LEDs-by-glowingkitty/GlowCore/README.md

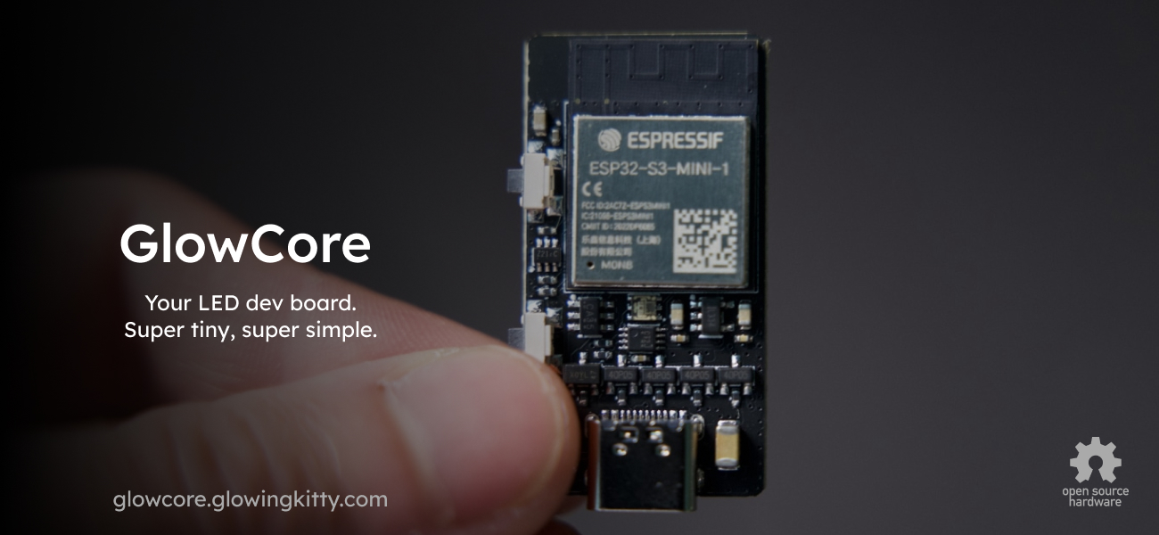
[picture p1: glowcore.jpg]
GlowCore


## What is this project?

A beautiful looking LED lamp for lighting up your home and setting the mood.

## Links

- [Shop](https://shop.glowingkitty.com/products/glowcore)
<!-- - [More details](https://glowingkitty.com/glowcore)
- [Tech specs](https://glowingkitty.com/glowcore/specs)
- [FAQ](https://glowingkitty.com/glowcore/faq)
- [Documents](https://glowingkitty.com/glowcore/docs)
- [3D files](https://glowingkitty.com/glowcore/3d)
- [PCB files](https://glowingkitty.com/glowcore/pcb) -->
