LEDs-by-glowingkitty/GlowCore/images/glowcore_backside.jpg

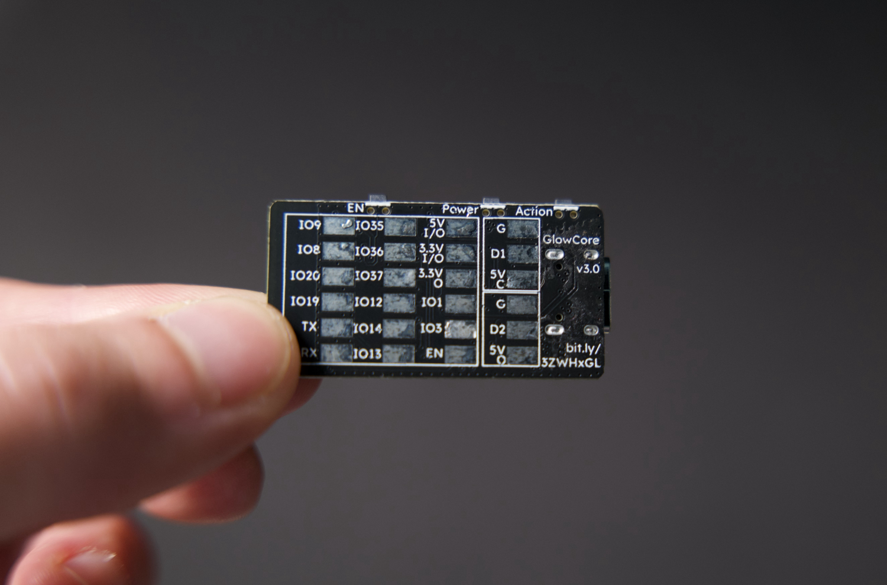
images/glowcore_backside.jpg
