LEDs-by-glowingkitty/GlowCore/images/glowcore_mainpicture.jpg

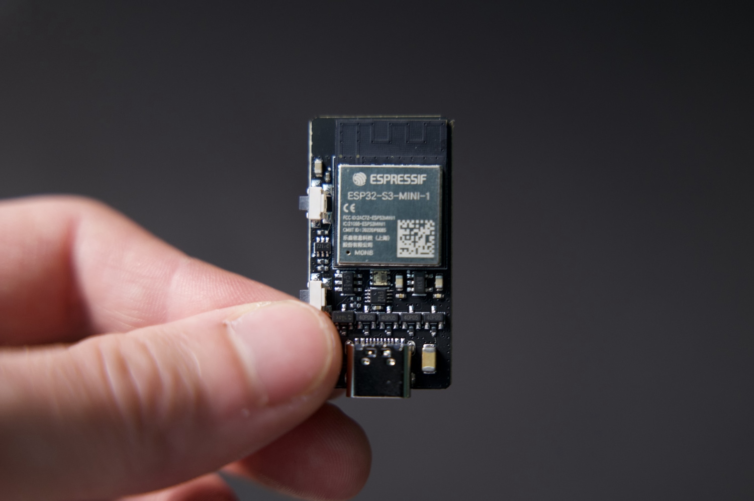
images/glowcore_mainpicture.jpg
