LEDs-by-glowingkitty/GlowCore/images/glowcore_packaging_back.jpg

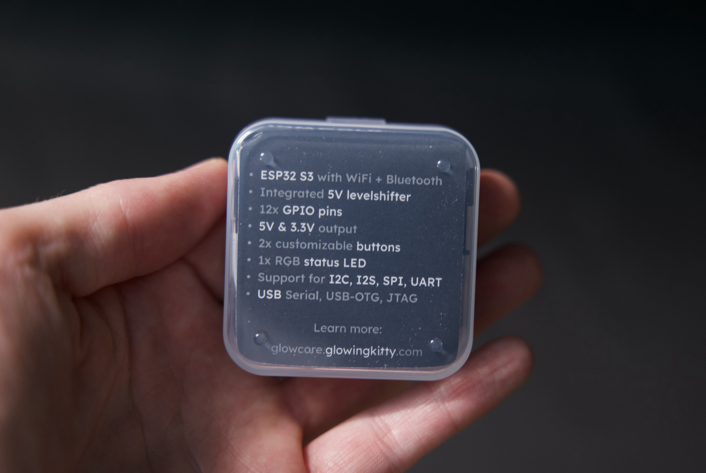
images/glowcore_packaging_back.jpg
