LEDs-by-glowingkitty/GlowCore/images/glowcore_packaging_front.jpg

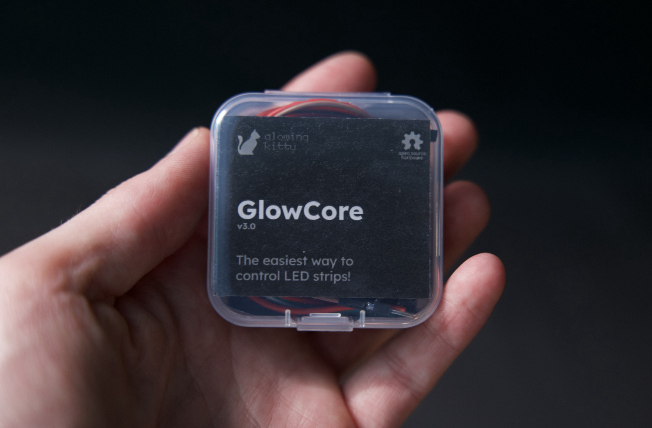
images/glowcore_packaging_front.jpg
