LEDs-by-glowingkitty/GlowCore/documents/GlowCore v3.0 pinout.pdf

# glowingkitty

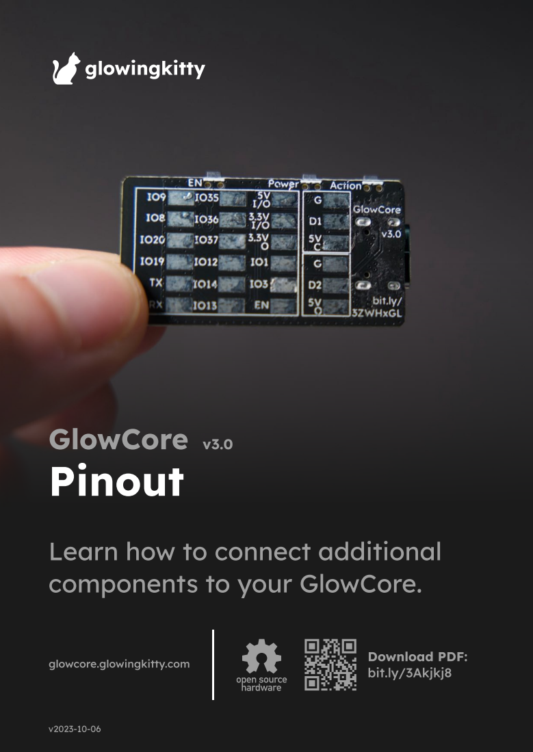
[picture p17: page 1]
GlowCore v3.0 Pinout; glowcore.glowingkitty.com; Download PDF:; bit.ly/3Akjkj8

Learn how to connect additional
components to your GlowCore.

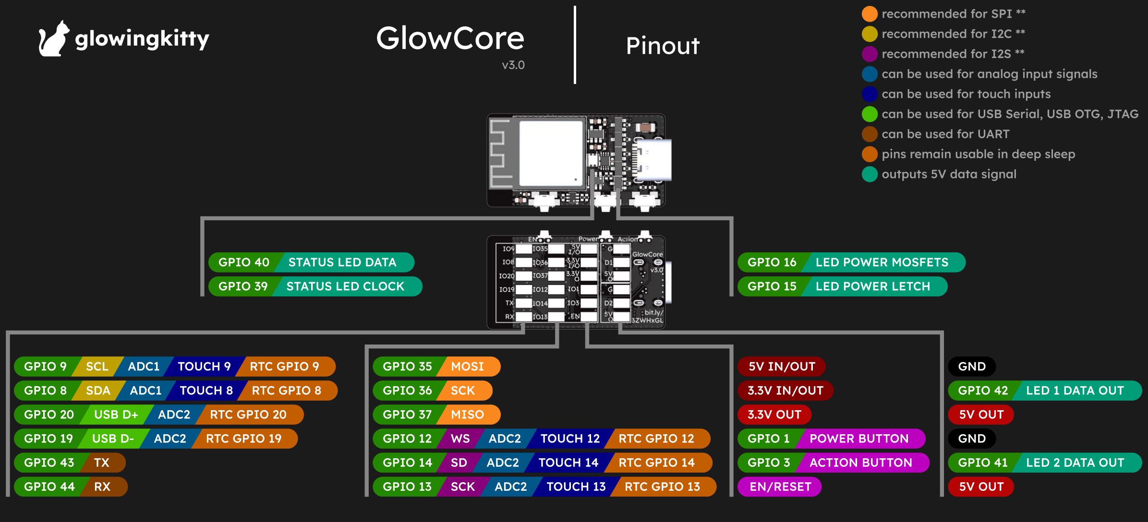
[picture p18: figure]
GlowCore; Pinout; recommended for SPI **; recommended for I2C **; recommended for I2S **; can be used for analog input signals; can be used for touch inputs; can be used for UART; pins remain usable in deep sleep; outputs 5V data signal; GND; GPIO 42; LED 1 DATA OUT; 5V OUT; GPIO 41; LED 2 DATA OUT; 5V IN/OUT; 3.3V IN/OUT; 3.3V OUT; GPIO 1; POWER BUTTON; GPIO 3; ACTION BUTTON; EN/RESET; GPIO 35; MOSI; GPIO 36; SCK; GPIO 37; MISO; GPIO 12; ADC2; TOUCH 12; RTC GPIO 12; GPIO 14; TOUCH 14; RTC GPIO 14; GPIO 13; TOUCH 13; RTC GPIO 13; GPIO 9; SCL; ADC1; TOUCH 9; RTC GPIO 9; GPIO 8; SDA; TOUCH 8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

can be used for USB Serial, USB OTG, JTAG

GPIO 3 | ACTION BUTTON
S | Next LED presec
S | Change brightness
| While holding the button, the brightness first
| decreases and once the minimum is reached, it
| increases again.
Press | Hold

Press

GPIO 1 | POWER BUTTON
S | Standby Mode
S | Turn off/on WiFi

Press

Press | Press
To turn on again, press the | once.

Every GPIO pin can be used for: I2C, SPI, I2S
Pull to GND, to trigger button (For your code, keep in mind: LOW signal will

be inverted to HIGH on GlowCore)

Button presets require GlowOS 0.15 or newer installed on GlowCore.

*

POWER BUTTON

**

***

*** | ***
glowcore.glowingkitty.com | Download PDF:

## bit.ly/3Akjkj8

v2023-10 06
