LEDs-by-glowingkitty/GlowCore/documents/GlowCore v3.0 schematic.pdf

# glowingkitty

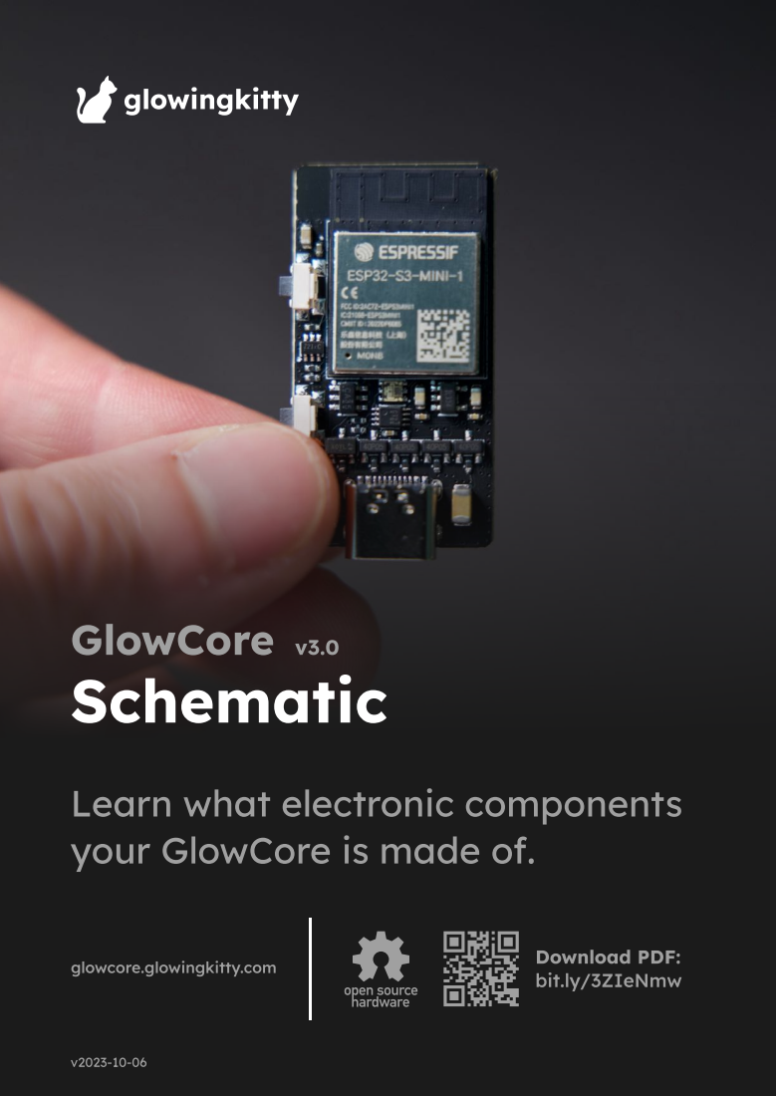
[picture p19: page 1]
GlowCore v3.0 Schematic; glowcore.glowingkitty.com; Download PDF:; bit.ly/3ZIeNmw

Learn what electronic components
your GlowCore is made of.

# GlowCore

# Schematic

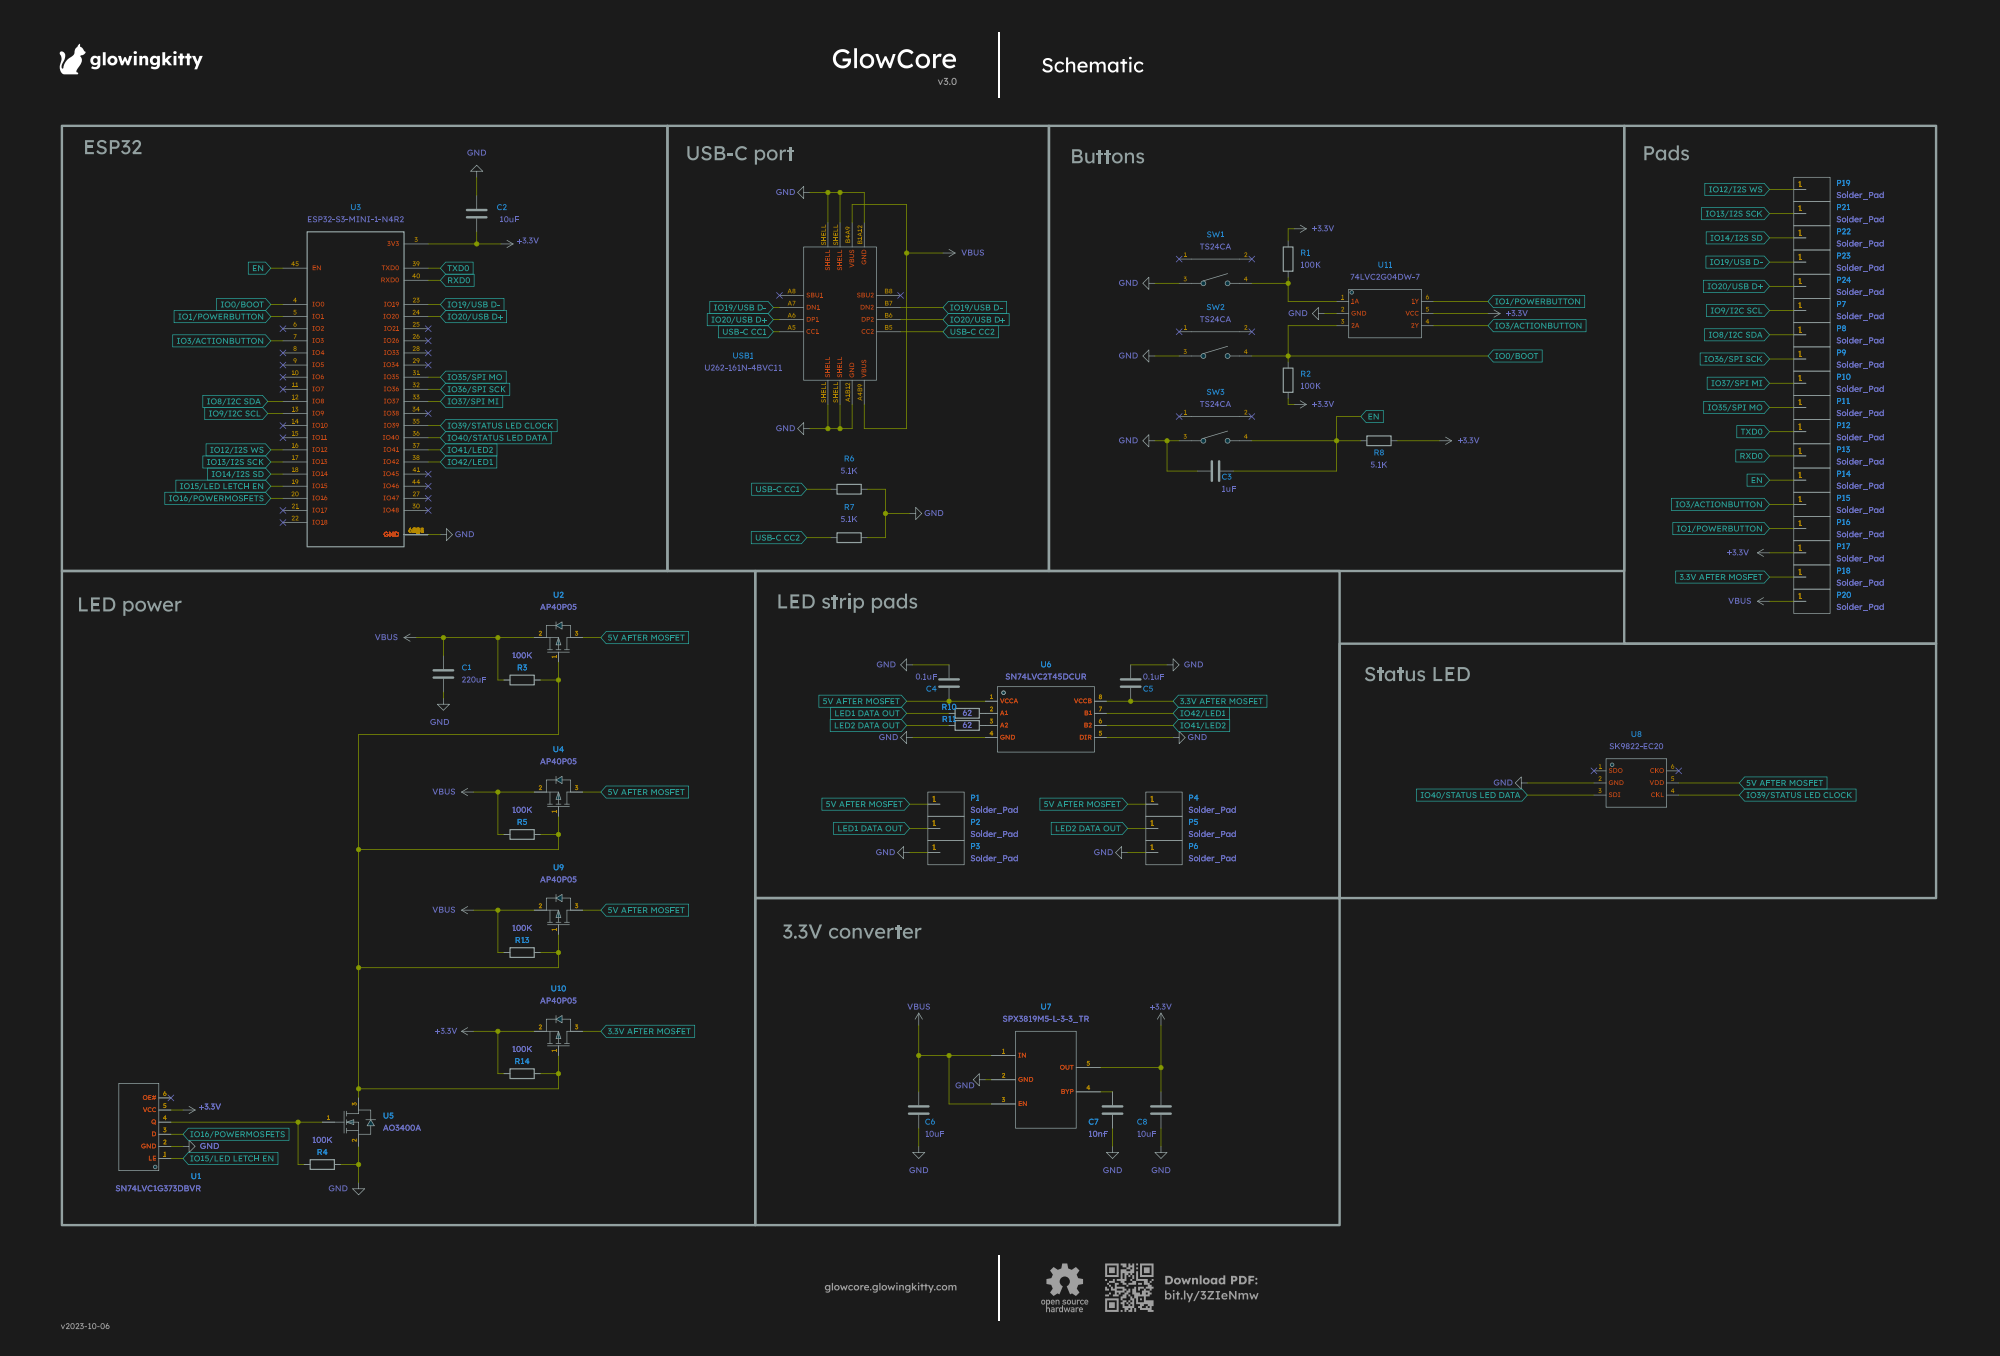
[picture p20: page 2]
glowcore.glowingkitty.com; Download PDF:; bit.ly/3ZIeNmw; glowingkitty
