LEDs-by-glowingkitty/GlowCore/elec/src/parts/buttons/TS_1185EC_C_D_B.pdf

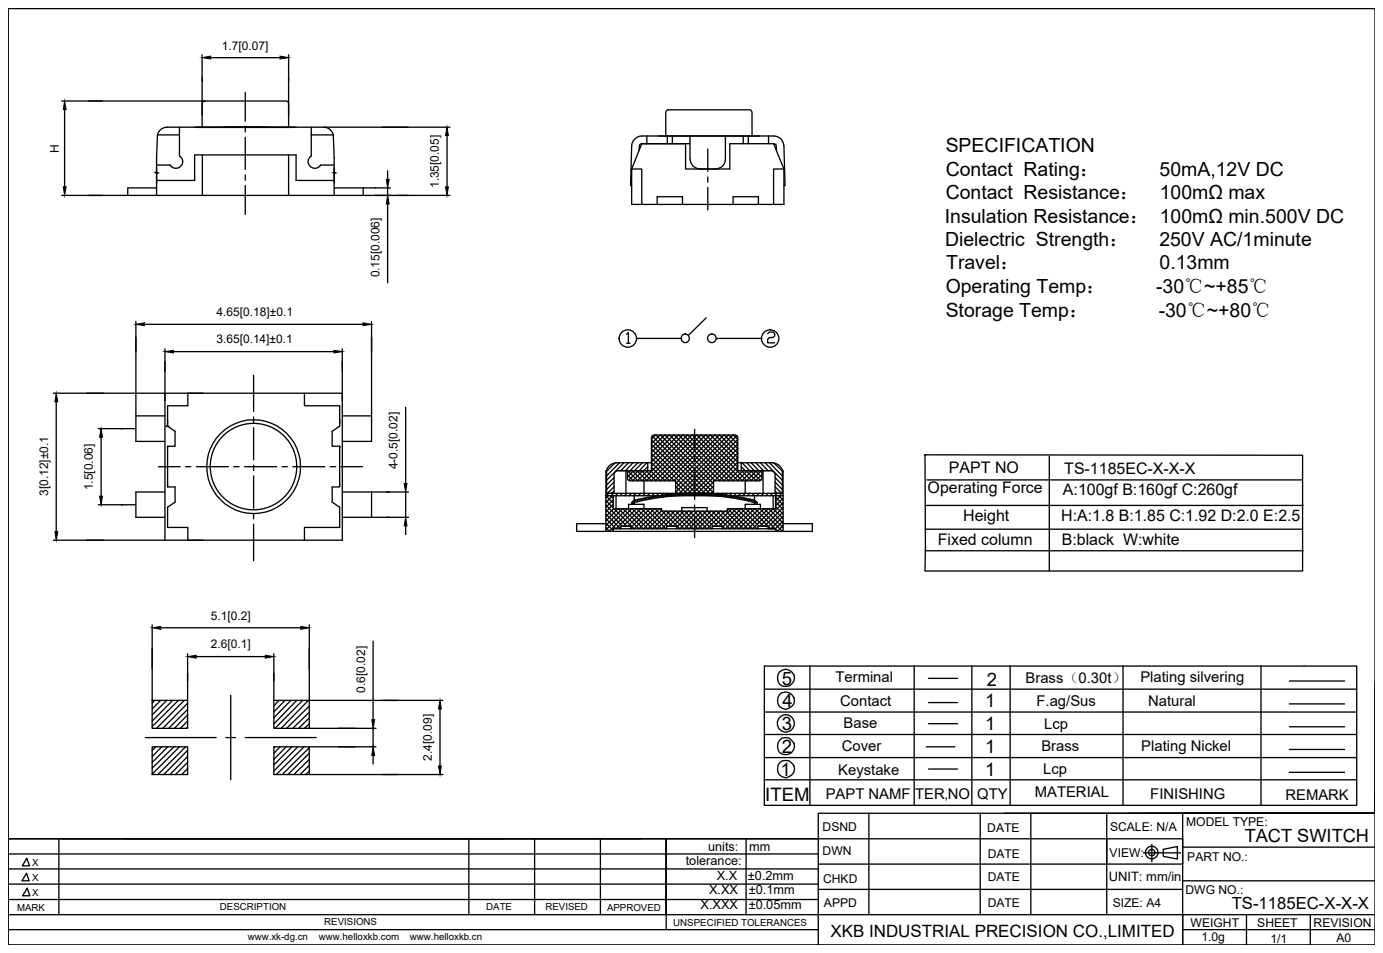
[picture p21: page 1]
XKB INDUSTRIAL PRECISION CO.,LIMITED; MODEL TYPE: PART NO.: DWG NO.: WEIGHT; SHEET; REVISION VIEW: SCALE: N/A SIZE: A4; A0 DSND; DATE DWN CHKD APPD; DATE DATE DATE; REVISED; APPROVED; DATE UNSPECIFIED TOLERANCES MARK; DESCRIPTION; REVISIONS XXX; www.xk-dg.cn www.helloxkb.com www.helloxkb.cn; TACT SWITCH A:100gf B:160gf C:260gf TS-1185EC-X-X-X Operating Force PAPT NO Height Fixed column; H:A:1.8 B:1.85 C:1.92 D:2.0 E:2.5 TS-1185EC-X-X-X B:black W:white units:; mm tolerance: X.X; ±0.1mm X.XXX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
