LEDs-by-glowingkitty/GlowCore/(commit log)

2021-12-22 added PCb design files (in development)
    [GlowCore.kicad_pcb, GlowCore.kicad_sch]
2021-12-22 added USB-C CC1 & CC2 to TUSB321
    [GlowCore.kicad_sch]
2021-12-22 added all Adafruit Feather32 parts
    [GlowCore.kicad_pcb, GlowCore.kicad_sch]
2021-12-22 added schematic pdf (still in development)
2021-12-22 selected correct levelshifter, started connecting strips
    [GlowCore.kicad_sch]
2021-12-22 moved to dos in schematic
    [GlowCore.kicad_sch]
2021-12-23 replaced levelshifter
    [GlowCore.kicad_sch]
2021-12-23 completed connecting LED strips
    [GlowCore.kicad_sch]
2021-12-23 tested if all components fit on board
    [GlowCore.kicad_pcb, GlowCore.kicad_sch]
2021-12-23 updated schematic preview
2021-12-26 fixed resistors
    [GlowCore.kicad_sch]
2021-12-31 added 5v 3a from USB-c port
    [GlowCore.kicad_sch]
2022-01-13 continued working on PCB design and schematic
    [GlowCore.kicad_pcb, GlowCore.kicad_sch]
2022-01-13 added PCBLayout pdf
    [GlowCore.kicad_pcb]
2022-01-13 updated todos
    [GlowCore.kicad_sch]
2022-01-13 added solder jumper for optional status led
    [GlowCore.kicad_pcb, GlowCore.kicad_sch]
2022-01-13 replaced level shifter
    [GlowCore.kicad_pcb, GlowCore.kicad_sch]
2022-01-14 added silk screen, started connecting traces
    [GlowCore.kicad_pcb, GlowCore.kicad_sch]
2022-01-15 started adding support for 5v from lipo
    [GlowCore.kicad_pcb, GlowCore.kicad_sch]
2022-01-19 added 5v step up chip and rearranged parts
    [GlowCore.kicad_pcb, GlowCore.kicad_sch]
2022-01-22 created first prototype of GlowCore, removed lipo
    [GlowCore-B_Adhesive.gbr, GlowCore-B_Cu.gbr, GlowCore-B_Mask.gbr, GlowCore-B_Paste.gbr, GlowCore-B_Silkscreen.gbr, GlowCore-Edge_Cuts.gbr, GlowCore-F_Adhesive.gbr, GlowCore-F_Cu.gbr]
2022-01-22 fixed outdated schematic
2022-01-29 re-added lipo support to schematic
    [GlowCore.kicad_pcb, GlowCore.kicad_sch]
2022-01-29 updated schematic
2022-01-30 added lipo support again + other fixes
    [GlowCore-B_Adhesive.gbr, GlowCore-B_Cu.gbr, GlowCore-B_Mask.gbr, GlowCore-B_Paste.gbr, GlowCore-B_Silkscreen.gbr, GlowCore-Edge_Cuts.gbr, GlowCore-F_Adhesive.gbr, GlowCore-F_Cu.gbr]
2022-02-01 updated pcb design (still in dev)
    [GlowCore.kicad_pcb, GlowCore.kicad_sch]
2022-02-02 changed connectors + finished prototype v1
    [GlowCore-CuBottom.gbr, GlowCore-CuTop.gbr, GlowCore-EdgeCuts.gbr, GlowCore-MaskBottom.gbr, GlowCore-MaskTop.gbr, GlowCore-NPTH.drl, GlowCore-PTH.drl, GlowCore-PasteBottom.gbr]
2022-02-02 updated schematic and pdf for pcb
2022-02-03 last fixes for v1 prototype
    [GlowCore-CuBottom.gbr, GlowCore-CuTop.gbr, GlowCore-EdgeCuts.gbr, GlowCore-MaskBottom.gbr, GlowCore-MaskTop.gbr, GlowCore-NPTH.drl, GlowCore-PTH.drl, GlowCore-PasteBottom.gbr]
2022-02-25 work on updating pcb design & added 3d models
    [GlowCore.kicad_pcb, GlowCore.kicad_sch]
2022-03-09 added new design v1.1
    [GlowCore-CuBottom.gbr, GlowCore-CuTop.gbr, GlowCore-EdgeCuts.gbr, GlowCore-MaskBottom.gbr, GlowCore-MaskTop.gbr, GlowCore-NPTH.drl, GlowCore-PTH.drl, GlowCore-PasteBottom.gbr]
2022-03-10 continued working on traces and designing PCB
    [GlowCore.kicad_pcb, GlowCore.kicad_sch]
2022-05-06 add warning
    [GlowCore.kicad_pcb]
2022-06-27 added complete redesign of GlowCore
    [Button PCB.kicad_pcb, Button PCB.kicad_sch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]
2022-07-05 added second schottky diode for less heat
    [Button PCB-CuBottom.gbr, Button PCB-CuTop.gbr, Button PCB-EdgeCuts.gbr, Button PCB-MaskBottom.gbr, Button PCB-MaskTop.gbr, Button PCB-NPTH.drl, Button PCB-PTH.drl, Button PCB-PasteBottom.gbr]
2022-07-05 updated button extension, added DC power extension
    [Button PCB-CuBottom.gbr, Button PCB-CuTop.gbr, Button PCB-MaskBottom.gbr, Button PCB-MaskTop.gbr, Button PCB-NPTH.drl, Button PCB-PTH.drl, Button PCB-PasteTop.gbr, Button PCB-SilkBottom.gbr]
2022-07-05 updated link on pcb
    [DC power-CuBottom.gbr, DC power-CuTop.gbr, DC power-EdgeCuts.gbr, DC power-MaskBottom.gbr, DC power-MaskTop.gbr, DC power-NPTH.drl, DC power-PTH.drl, DC power-PasteBottom.gbr]
2022-07-10 added tooling holes
    [GlowCore-CuBottom.gbr, GlowCore-CuTop.gbr, GlowCore-EdgeCuts.gbr, GlowCore-MaskBottom.gbr, GlowCore-MaskTop.gbr, GlowCore-NPTH.drl, GlowCore-PTH.drl, GlowCore-PasteBottom.gbr]
2022-07-17 updated pcb and header image
    [Button PCB.kicad_pcb, Connector Hub.kicad_pcb, Connector Hub.kicad_sch, DC power.kicad_pcb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]
2022-07-17 removed connector hub pcb, not needed
    [Connector Hub.kicad_pcb, Connector Hub.kicad_sch]
2022-07-18 fixed smd nut hole size and position
    [GlowCore-CuBottom.gbr, GlowCore-CuTop.gbr, GlowCore-EdgeCuts.gbr, GlowCore-MaskBottom.gbr, GlowCore-MaskTop.gbr, GlowCore-NPTH.drl, GlowCore-PTH.drl, GlowCore-PasteBottom.gbr]
2022-08-24 added cover sticker, started updating PCB design
    [GlowCore.kicad_pcb, GlowCore.kicad_sch, cover.stl]
2022-09-08 upcated glowcore pcb and started adding extension
    [5V converter-CuBottom.gbr, 5V converter-CuTop.gbr, 5V converter-EdgeCuts.gbr, 5V converter-MaskBottom.gbr, 5V converter-MaskTop.gbr, 5V converter-NPTH.drl, 5V converter-PTH.drl, 5V converter-PasteBottom.gbr]
2022-09-09 updated pcb files
    [GlowCore-B_Cu.gbr, GlowCore-B_Mask.gbr, GlowCore-B_Paste.gbr, GlowCore-B_Silkscreen.gbr, GlowCore-Edge_Cuts.gbr, GlowCore-F_Cu.gbr, GlowCore-F_Mask.gbr, GlowCore-F_Paste.gbr]
2022-09-10 update gpio pins and added vbus connection
    [GlowCore-B_Cu.gbr, GlowCore-B_Mask.gbr, GlowCore-B_Paste.gbr, GlowCore-B_Silkscreen.gbr, GlowCore-CuBottom.gbr, GlowCore-CuTop.gbr, GlowCore-EdgeCuts.gbr, GlowCore-Edge_Cuts.gbr]
2022-10-03 updated GlowCore to v2, started battery converter
    [5V converter-CuBottom.gbr, 5V converter-CuTop.gbr, 5V converter-EdgeCuts.gbr, 5V converter-MaskBottom.gbr, 5V converter-MaskTop.gbr, 5V converter-NPTH.drl, 5V converter-PTH.drl, 5V converter-PasteBottom.gbr]
2022-10-03 update images to v2
    [GlowCore-B_Cu.gbr, GlowCore-B_Mask.gbr, GlowCore-B_Paste.gbr, GlowCore-B_Silkscreen.gbr, GlowCore-Edge_Cuts.gbr, GlowCore-F_Cu.gbr, GlowCore-F_Mask.gbr, GlowCore-F_Paste.gbr]
2022-10-05 started replacing 0603 with 0402 caps and resistor
    [Battery Extension.kicad_pcb, Battery Extension.kicad_sch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]
2022-11-16 updated GlowCore PCB
    [Battery Extension.kicad_pcb, Battery Extension.kicad_sch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]
2022-11-16 updated pcb
    [GlowCore-CuBottom.gbr, GlowCore-CuTop.gbr, GlowCore-EdgeCuts.gbr, GlowCore-MaskBottom.gbr, GlowCore-MaskTop.gbr, GlowCore-NPTH.drl, GlowCore-PTH.drl, GlowCore-PasteBottom.gbr]
2022-11-18 added status led
    [GlowCore-CuBottom.gbr, GlowCore-CuTop.gbr, GlowCore-EdgeCuts.gbr, GlowCore-MaskBottom.gbr, GlowCore-MaskTop.gbr, GlowCore-NPTH.drl, GlowCore-PTH.drl, GlowCore-PasteBottom.gbr]
2022-12-07 added buttons extension quick start
2022-12-14 updated 3d printed case
    [GlowCore.kicad_sch, case A.stl, case B.stl, cover.stl]
2023-02-05 made changes to pcb and 3d model
    [GlowCore.kicad_pcb, GlowCore.kicad_sch, case A.stl, case B.stl]
2023-04-10 replaced GlowCore with GlowCore Nano design
    [Battery Extension-B_Cu.gbr, Battery Extension-B_Mask.gbr, Battery Extension-B_Paste.gbr, Battery Extension-B_Silkscreen.gbr, Battery Extension-CuBottom.gbr, Battery Extension-CuTop.gbr, Battery Extension-EdgeCuts.gbr, Battery Extension-Edge_Cuts.gbr]
2023-04-10 update folder structure
    [GlowCore.kicad_pcb, GlowCore.kicad_sch]
2023-04-24 uploading documents of v3.0
    [GlowCore.kicad_pcb, GlowCorePanel.kicad_sch]
2023-07-12 updated pcb design
    [GlowCore.kicad_pcb, GlowCore.kicad_sch]
2023-07-12 added updated schematic
2023-08-10 added 3.1 pinout
    [battery extension.kicad_pcb, battery extension.kicad_sch]
2024-03-28 started creating new PCB design using atopile
    [glowcore.kicad_pcb, glowcore.kicad_sch]
